koushiniku/bvclock/schematics/bvclock.pdf

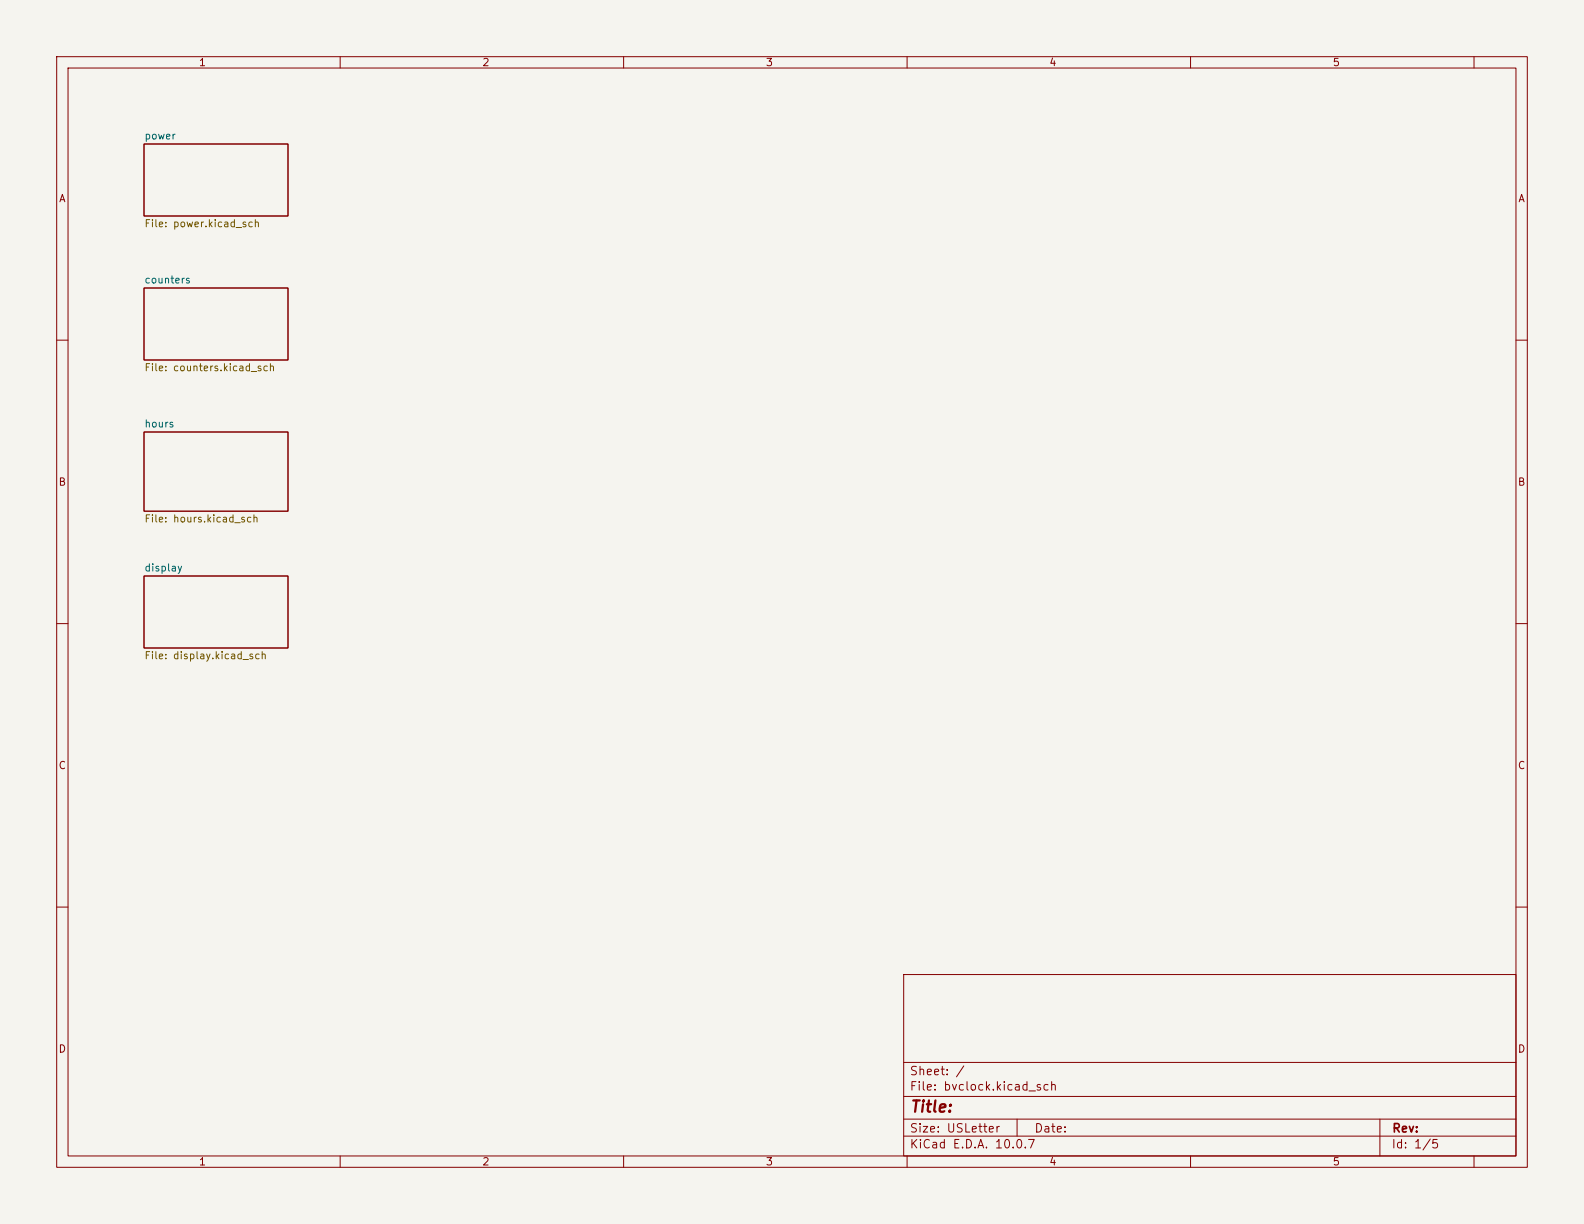
[picture p1: page 1]

Size: USLetter | Rev:
KiCad E.D.A. 10.0.7 | Id: 1/5

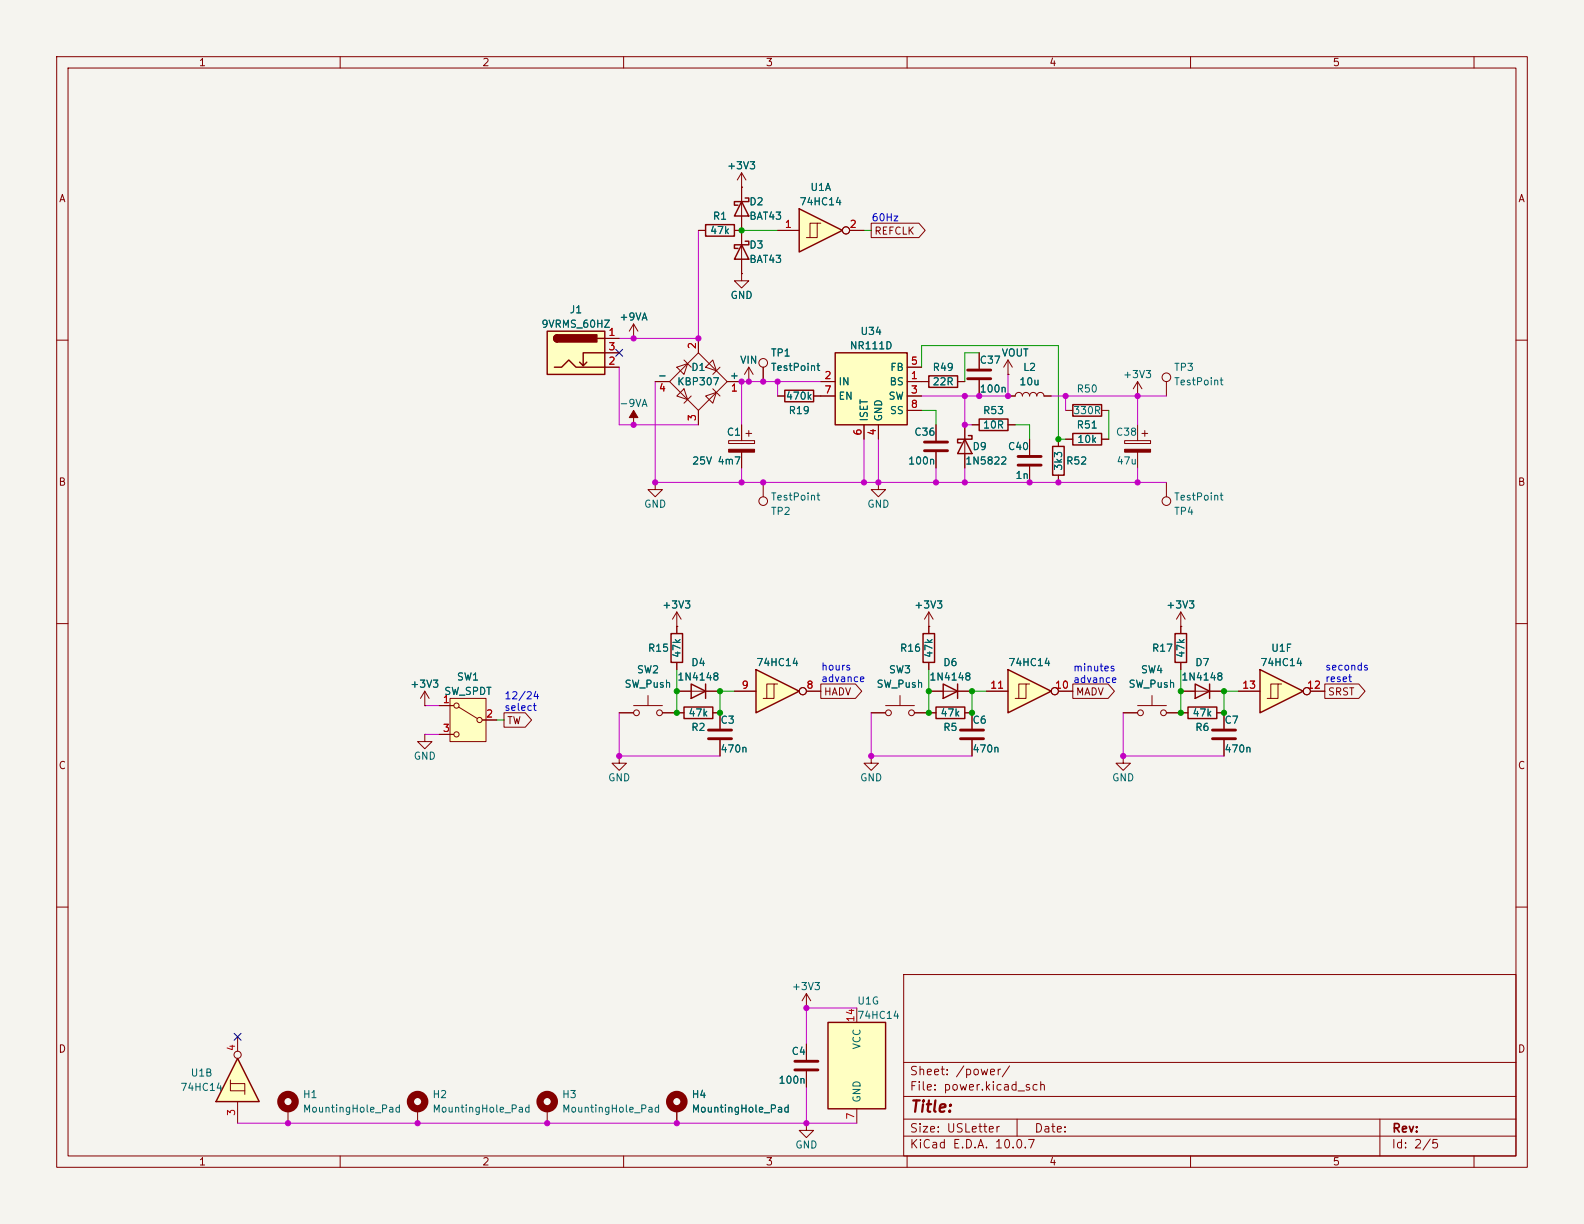
[picture p2: page 2]

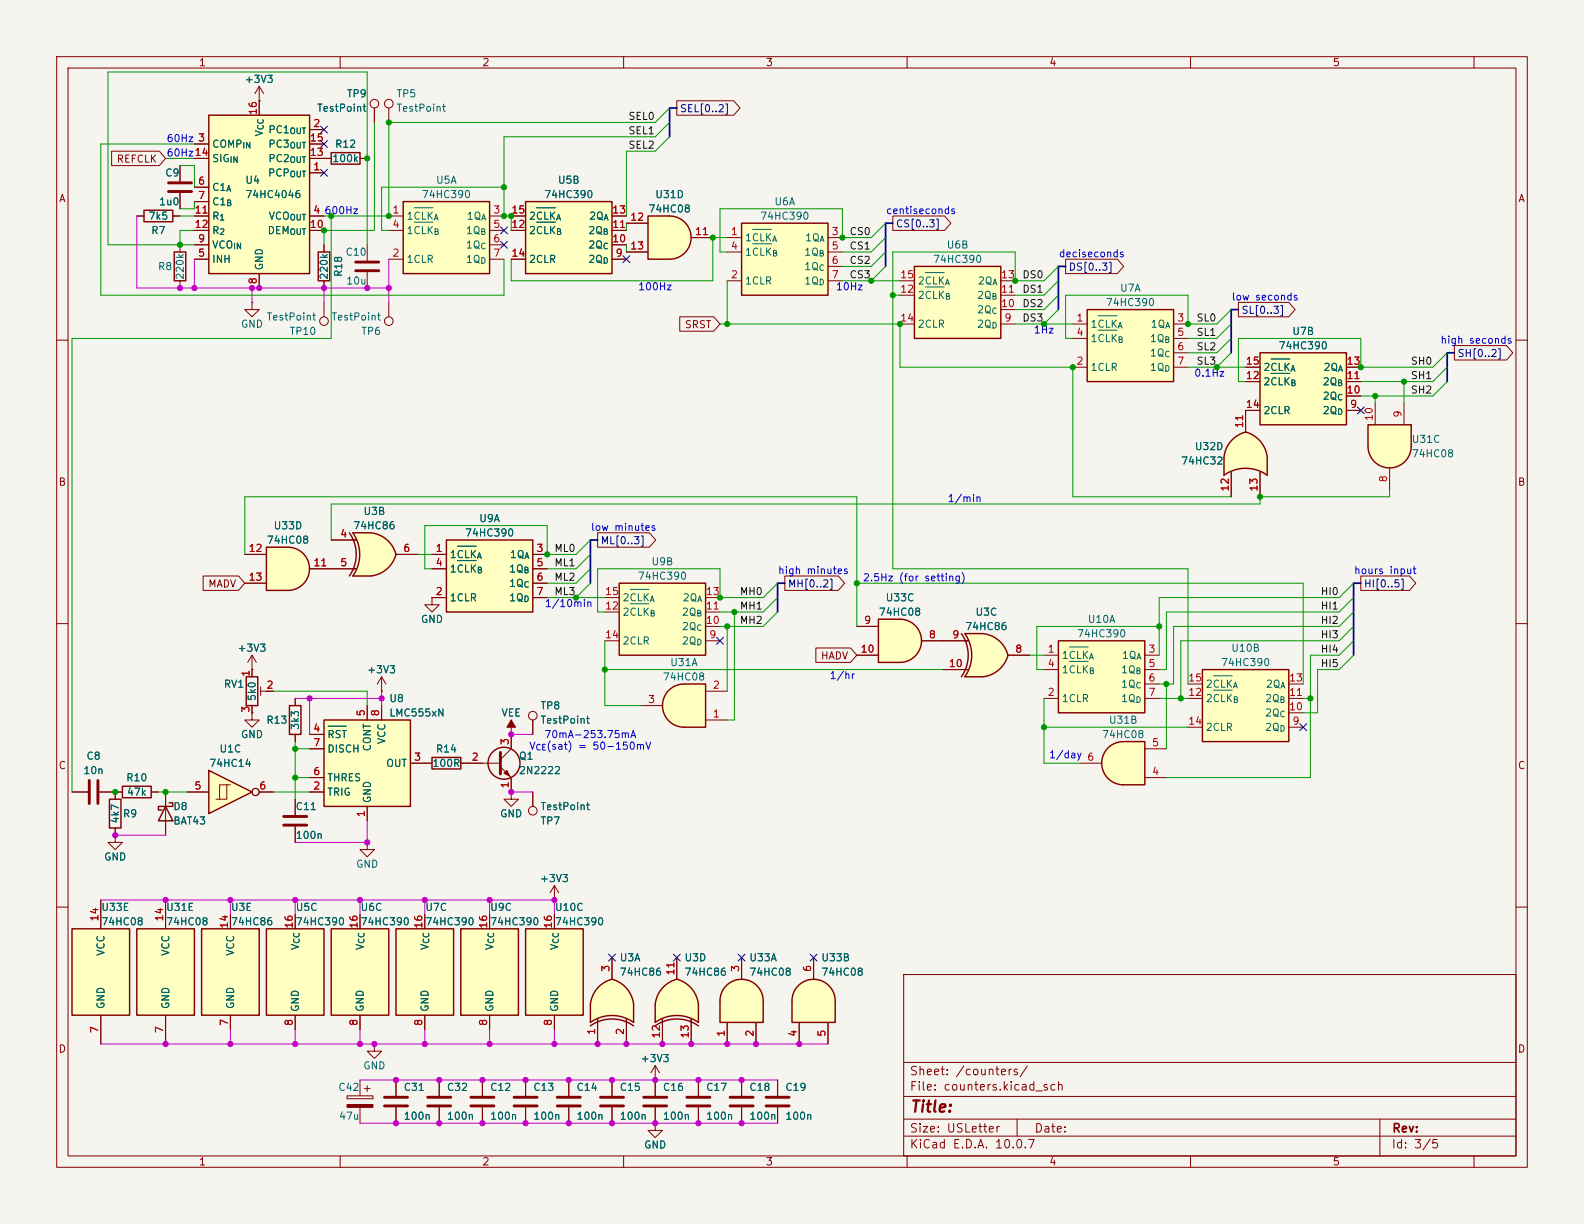
[picture p3: page 3]

74HC390 GND | 74HC390 GND | 74HC390 GND | 74HC390 GND | 74HC390 GND

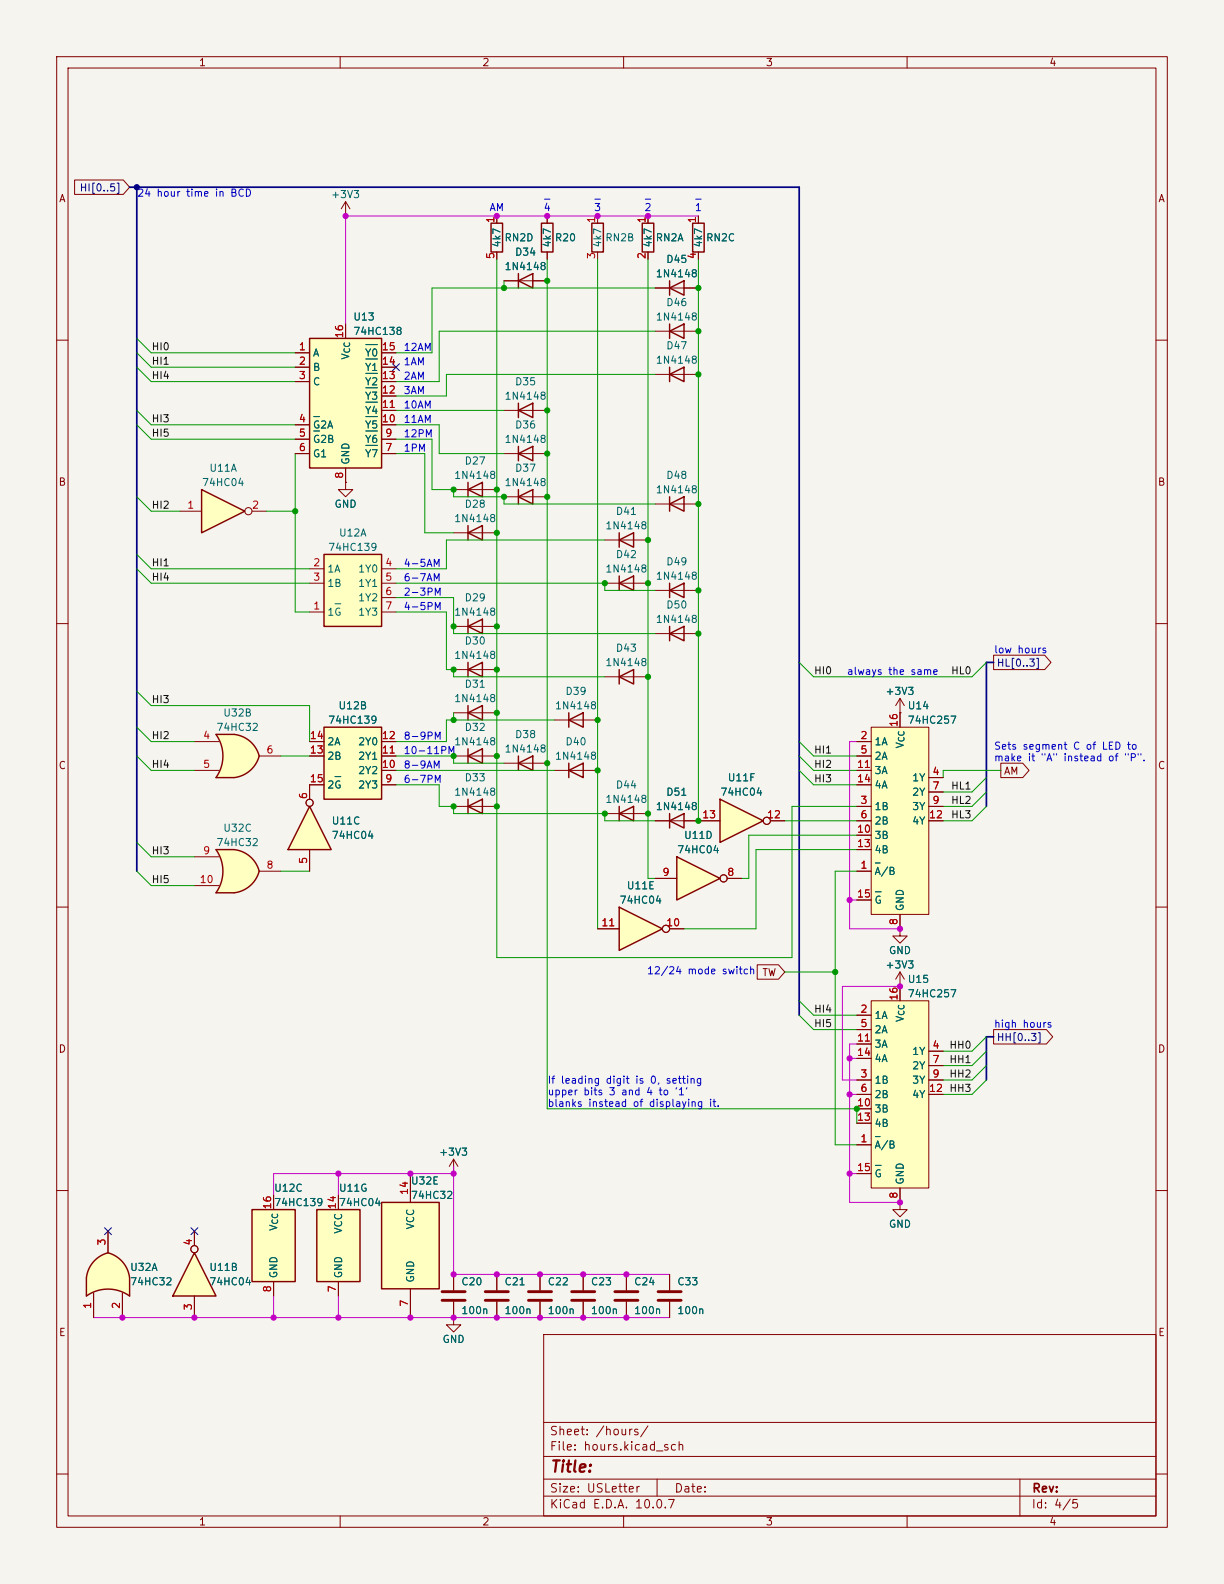
[picture p4: page 4]

24 hour time in BCD

8-9AM
6-7PM

If leading digit is 0, setting
upper bits 3 and 4 to '1' blanks instead of displaying it.

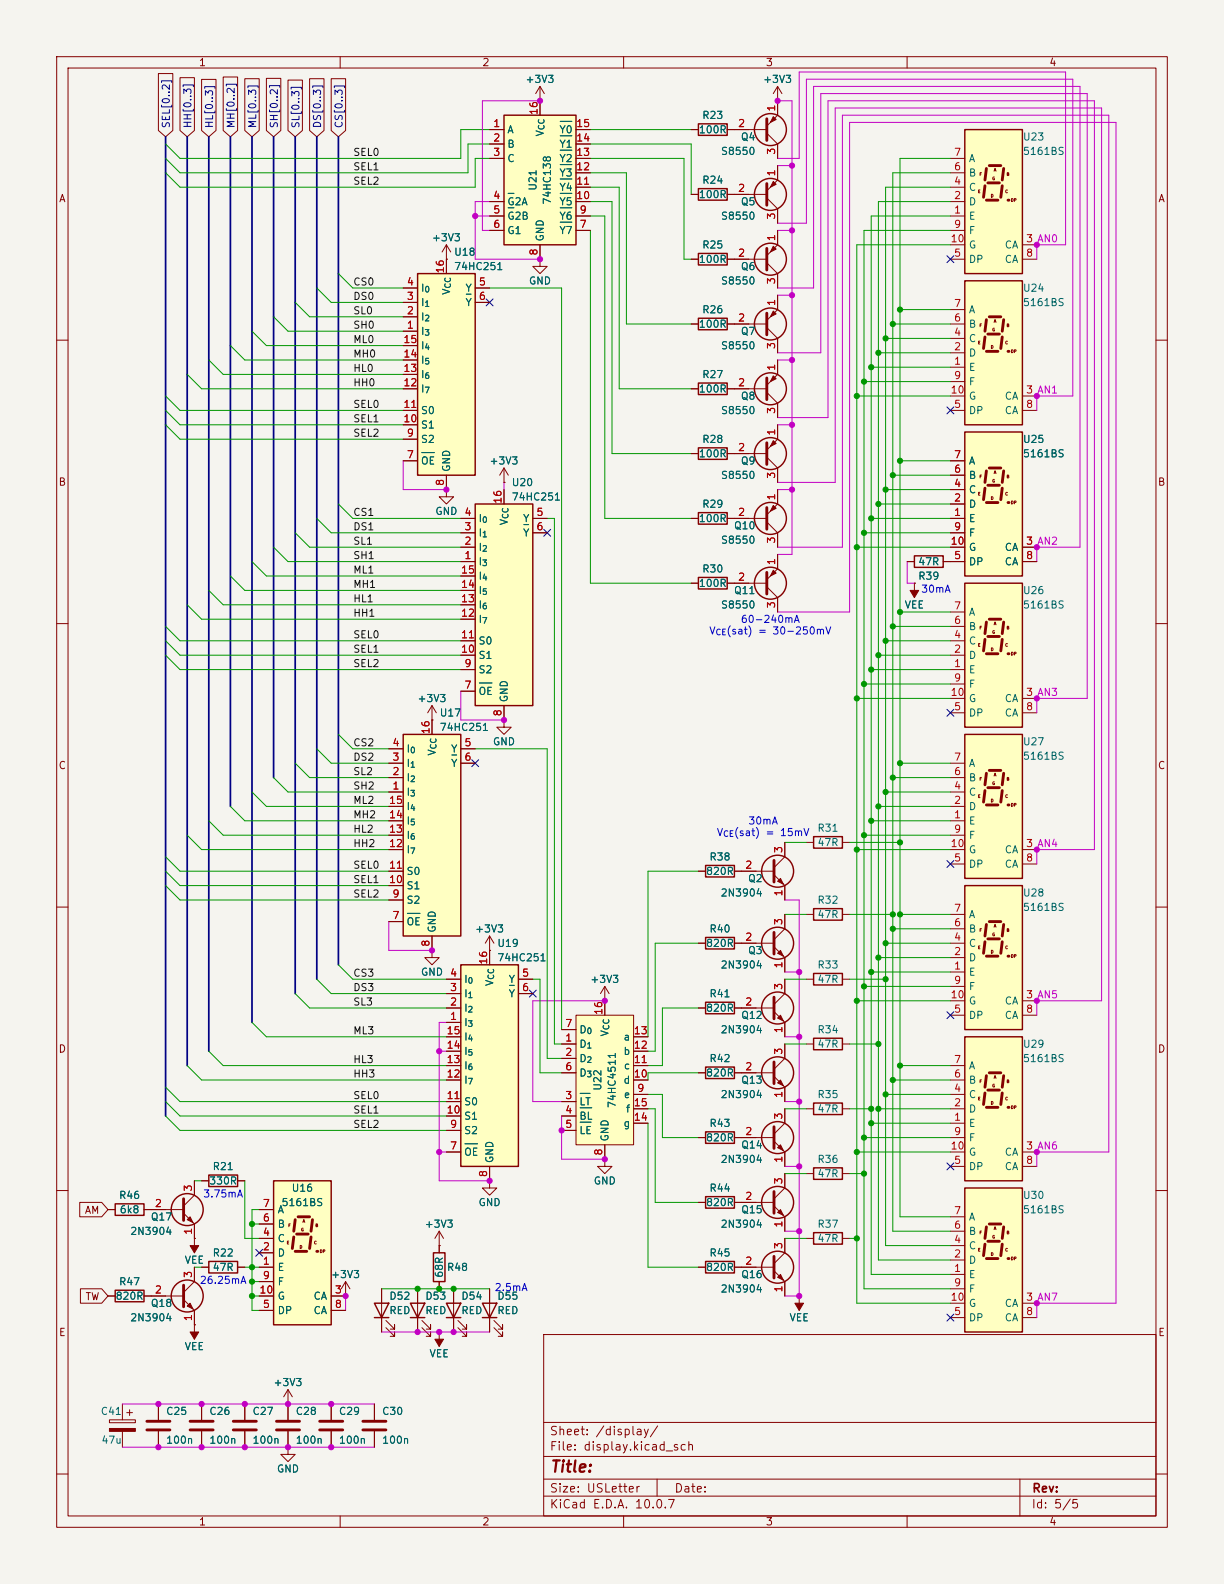
[picture p5: page 5]

SEL1
