koushiniku/bvclock/schematics/bvclock.kicad_pcb

## KiCad design schematics/bvclock.kicad_pcb (2026-10-28)

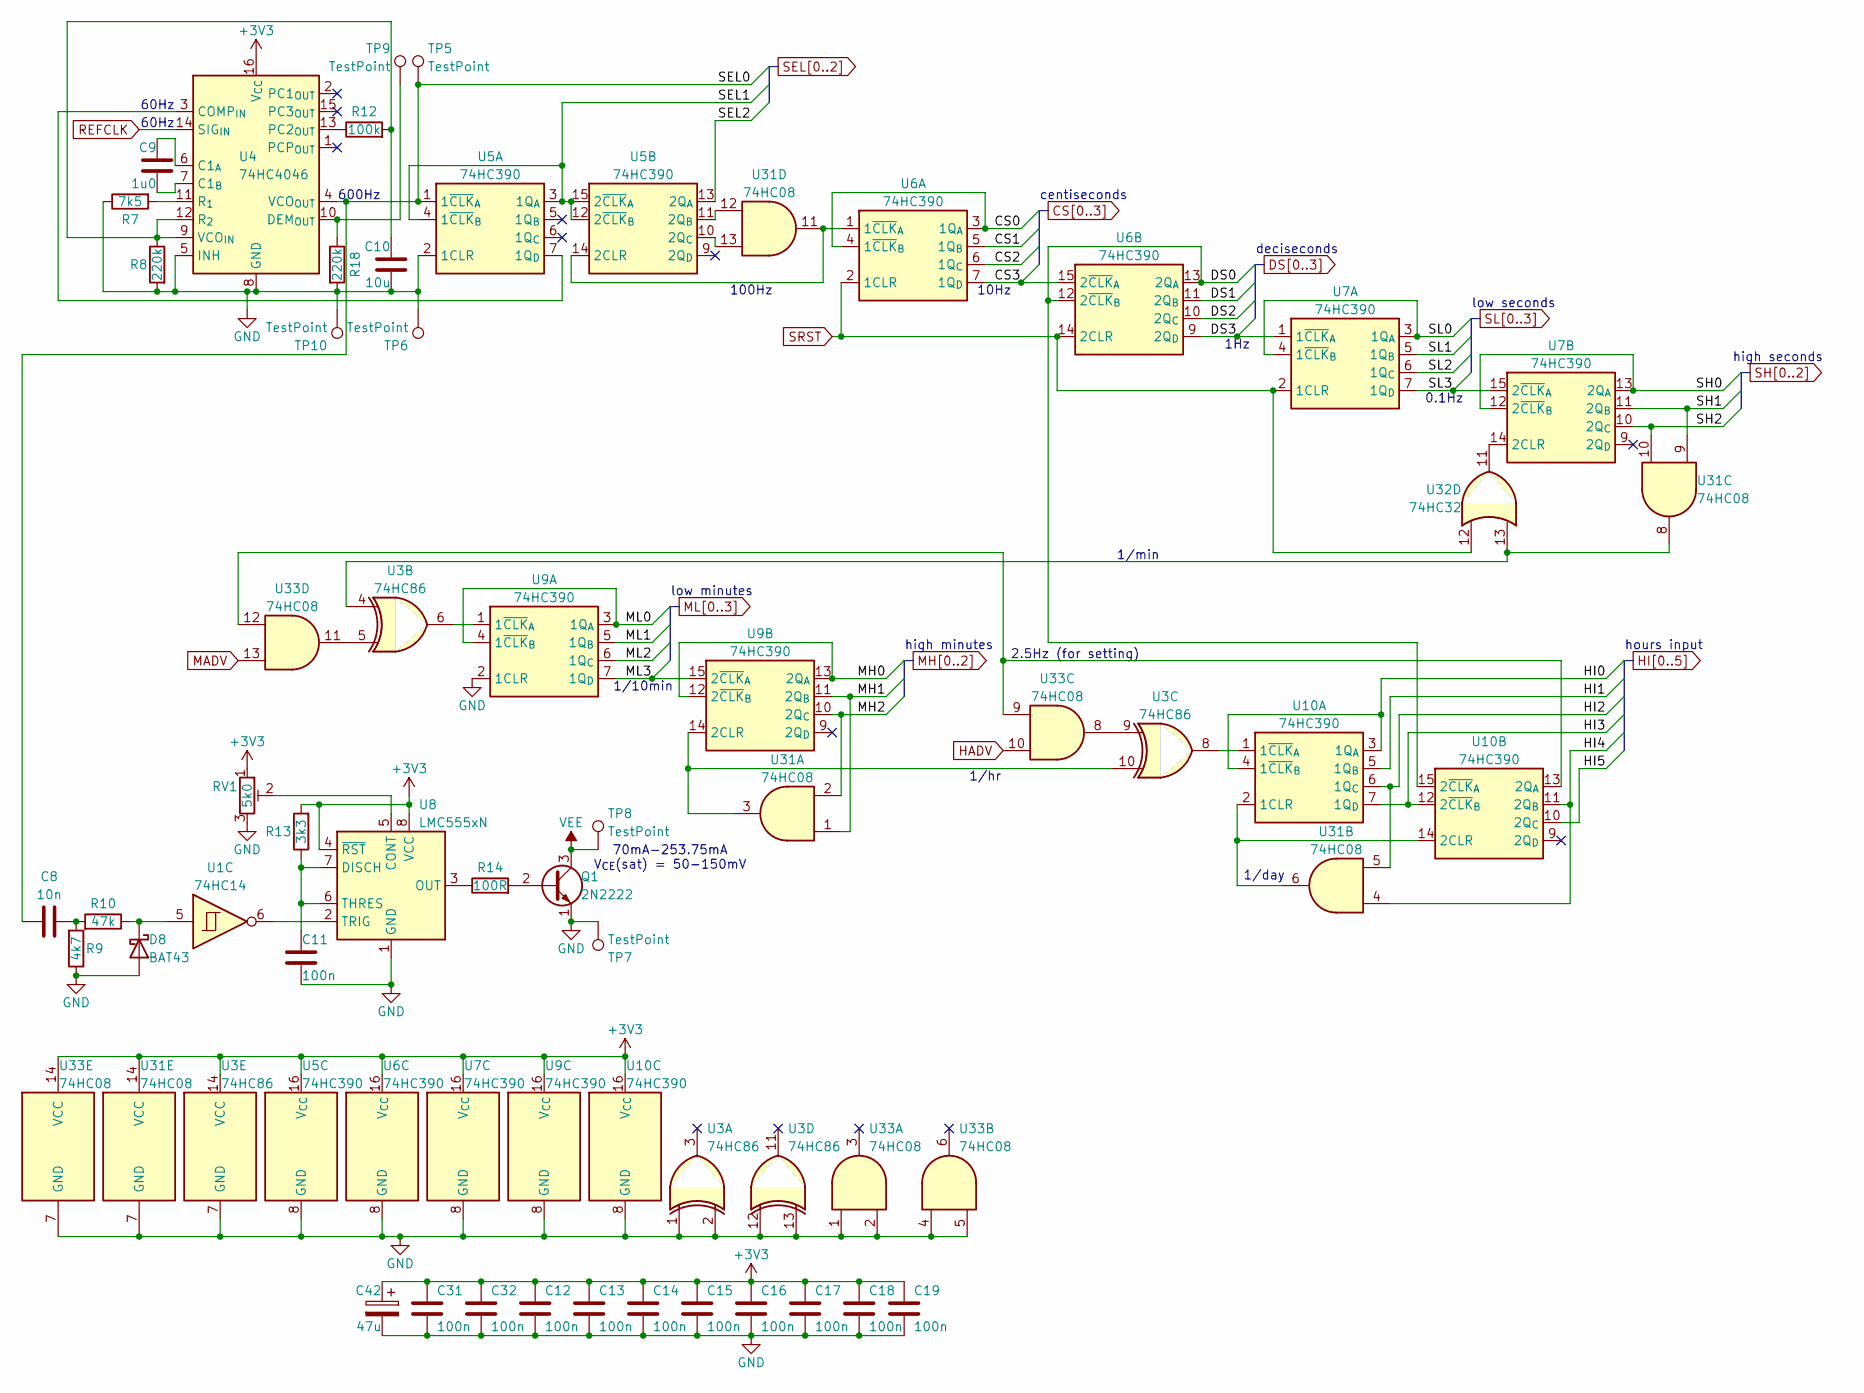
[picture p6: schematic counters.kicad_sch]

Parts:
C8: 10n; THT_Cap
C9: 1u0; THT_Cap
C10: 10u; THT_Cap
C11, C12, C13, C14, C15, C16, C17, C18, C19, C31, C32: 100n; THT_Cap
C42: 47u; CP_Radial_D5.0mm_P2.00mm
D8: BAT43; THT_D_Vertical
Q1: 2N2222; TO-92_HandSolder
R7: 7k5; THT_R_Vertical
R8, R18: 220k; THT_R_Vertical
R9: 4k7; THT_R_Vertical
R10: 47k; THT_R_Vertical
R12: 100k; THT_R_Vertical
R13: 3k3; THT_R_Vertical
R14: 100R; THT_R_Vertical
RV1: 5k0; Bourns_3362P_Trimming_Potentiometer
TP5, TP8, TP9: TestPoint; TestPoint_THTPad_2.5x2.5mm_Drill1.2mm
TP6, TP7, TP10: TestPoint; TestPoint_THTPad_D1.0mm_Drill0.5mm
U1: 74HC14; DIP-14_W7.62mm
U3: 74HC86; DIP-14_W7.62mm
U4: 74HC4046; DIP-16_W7.62mm
U5, U6, U7, U9, U10: 74HC390; DIP-16_W7.62mm
U8: LMC555xN; DIP-8_W7.62mm
U31, U33: 74HC08; DIP-14_W7.62mm
U32: 74HC32; DIP-14_W7.62mm

Connections:
+3V3: C12.1, C13.1, C14.1, C15.1, C16.1, C17.1, C18.1, C19.1, C31.1, C32.1, C42.1, R13.2, RV1.1, U3.14 (VCC), U4.16 (V_{CC}), U5.16 (V_{CC}), U6.16 (V_{CC}), U7.16 (V_{CC}), U8.4 (~RST), U8.8 (VCC), U9.16 (V_{CC}), U10.16 (V_{CC}), U31.14 (VCC), U33.14 (VCC); also elsewhere on the board
CS0: U6.3 (1Q_{A}), U6.4 (1~CLK_{B}); also elsewhere on the board
CS1: U6.5 (1Q_{B}); also elsewhere on the board
CS2: U6.6 (1Q_{C}); also elsewhere on the board
CS3: U6.7 (1Q_{D}), U6.15 (2~CLK_{A}); also elsewhere on the board
DS0: U6.12 (2~CLK_{B}), U6.13 (2Q_{A}), U10.15 (2~CLK_{A}); also elsewhere on the board
DS1: U6.11 (2Q_{B}); also elsewhere on the board
DS2: U6.10 (2Q_{C}); also elsewhere on the board
DS3: U6.9 (2Q_{D}), U7.1 (1~CLK_{A}); also elsewhere on the board
GND: C10.2, C11.2, C12.2, C13.2, C14.2, C15.2, C16.2, C17.2, C18.2, C19.2, C31.2, C32.2, C42.2, D8.2 (A), Q1.1 (E), R7.1, R8.2, R9.1, R18.2, RV1.3, TP6.1 (1_1), TP7.1 (1_1), TP10.1 (1_1), U3.1, U3.2, U3.7 (GND), U3.12, U3.13, U4.5 (INH), U4.8 (GND), U5.2 (1CLR), U5.8 (GND), U6.8 (GND), U7.8 (GND), U8.1 (GND), U9.2 (1CLR), U9.8 (GND), U10.8 (GND), U31.7 (GND), U33.1, U33.2, U33.4, U33.5, U33.7 (GND); also elsewhere on the board
HADV: U33.10; also elsewhere on the board
HI0: U10.3 (1Q_{A}), U10.4 (1~CLK_{B}); also elsewhere on the board
HI1: U10.5 (1Q_{B}); also elsewhere on the board
HI2: U10.6 (1Q_{C}), U31.5; also elsewhere on the board
HI3: U10.7 (1Q_{D}), U10.12 (2~CLK_{B}); also elsewhere on the board
HI4: U10.11 (2Q_{B}), U31.4; also elsewhere on the board
HI5: U10.10 (2Q_{C}); also elsewhere on the board
MADV: U33.13; also elsewhere on the board
MH0: U9.12 (2~CLK_{B}), U9.13 (2Q_{A}); also elsewhere on the board
MH1: U9.11 (2Q_{B}), U31.1; also elsewhere on the board
MH2: U9.10 (2Q_{C}), U31.2; also elsewhere on the board
ML0: U9.3 (1Q_{A}), U9.4 (1~CLK_{B}); also elsewhere on the board
ML1: U9.5 (1Q_{B}); also elsewhere on the board
ML2: U9.6 (1Q_{C}); also elsewhere on the board
ML3: U9.7 (1Q_{D}), U9.15 (2~CLK_{A}); also elsewhere on the board
unnamed: C8.2, R9.2, R10.2
unnamed: D8.1 (K), R10.1, U1.5
unnamed: Q1.2 (B), R14.2
unnamed: U3.4, U31.8, U32.13
unnamed: U3.5, U33.11
unnamed: U3.9, U33.8
unnamed: C9.1, U4.6 (C1_{A})
unnamed: C9.2, U4.7 (C1_{B})
unnamed: U4.3 (COMP_{IN}), U5.7 (1Q_{D})
unnamed: R18.1, TP9.1 (1_1), U4.10 (DEM_{OUT})
unnamed: R12.1, U4.13 (PC2_{OUT})
unnamed: R7.2, U4.11 (R_{1})
unnamed: C10.1, R8.1, R12.2, U4.9 (VCO_{IN}), U4.12 (R_{2})
unnamed: U5.14 (2CLR), U6.1 (1~CLK_{A}), U31.11
unnamed: U5.11 (2Q_{B}), U31.12
unnamed: U5.10 (2Q_{C}), U31.13
unnamed: U7.14 (2CLR), U32.11
unnamed: RV1.2, U8.5 (CONT)
unnamed: C11.1, R13.1, U8.6 (THRES), U8.7 (DISCH)
unnamed: R14.1, U8.3 (OUT)
unnamed: U1.6, U8.2 (TRIG)
unnamed: U3.6, U9.1 (1~CLK_{A})
unnamed: U3.10, U9.14 (2CLR), U31.3
unnamed: U10.2 (1CLR), U10.14 (2CLR), U31.6
unnamed: U3.8, U10.1 (1~CLK_{A})
unnamed: U10.13 (2Q_{A}), U33.9, U33.12
REFCLK: U4.14 (SIG_{IN}); also elsewhere on the board
SEL0: C8.1, TP5.1 (1_1), U4.4 (VCO_{OUT}), U5.1 (1~CLK_{A}); also elsewhere on the board
SEL1: U5.3 (1Q_{A}), U5.4 (1~CLK_{B}), U5.12 (2~CLK_{B}), U5.15 (2~CLK_{A}); also elsewhere on the board
SEL2: U5.13 (2Q_{A}); also elsewhere on the board
SH0: U7.12 (2~CLK_{B}), U7.13 (2Q_{A}); also elsewhere on the board
SH1: U7.11 (2Q_{B}), U31.9; also elsewhere on the board
SH2: U7.10 (2Q_{C}), U31.10; also elsewhere on the board
SL0: U7.3 (1Q_{A}), U7.4 (1~CLK_{B}); also elsewhere on the board
SL1: U7.5 (1Q_{B}); also elsewhere on the board
SL2: U7.6 (1Q_{C}); also elsewhere on the board
SL3: U7.7 (1Q_{D}), U7.15 (2~CLK_{A}); also elsewhere on the board
SRST: U6.2 (1CLR), U6.14 (2CLR), U7.2 (1CLR), U32.12; also elsewhere on the board
VEE: Q1.3 (C), TP8.1 (1_1); also elsewhere on the board

Notes on the sheet:
low minutes
1/day
hours input
60Hz
1/hr
0.1Hz
high seconds
2.5Hz (for setting)
high minutes
100Hz
70mA-253.75mA V_{CE}(sat) = 50-150mV
1/10min
low seconds
deciseconds
1Hz
600Hz
centiseconds
10Hz
1/min

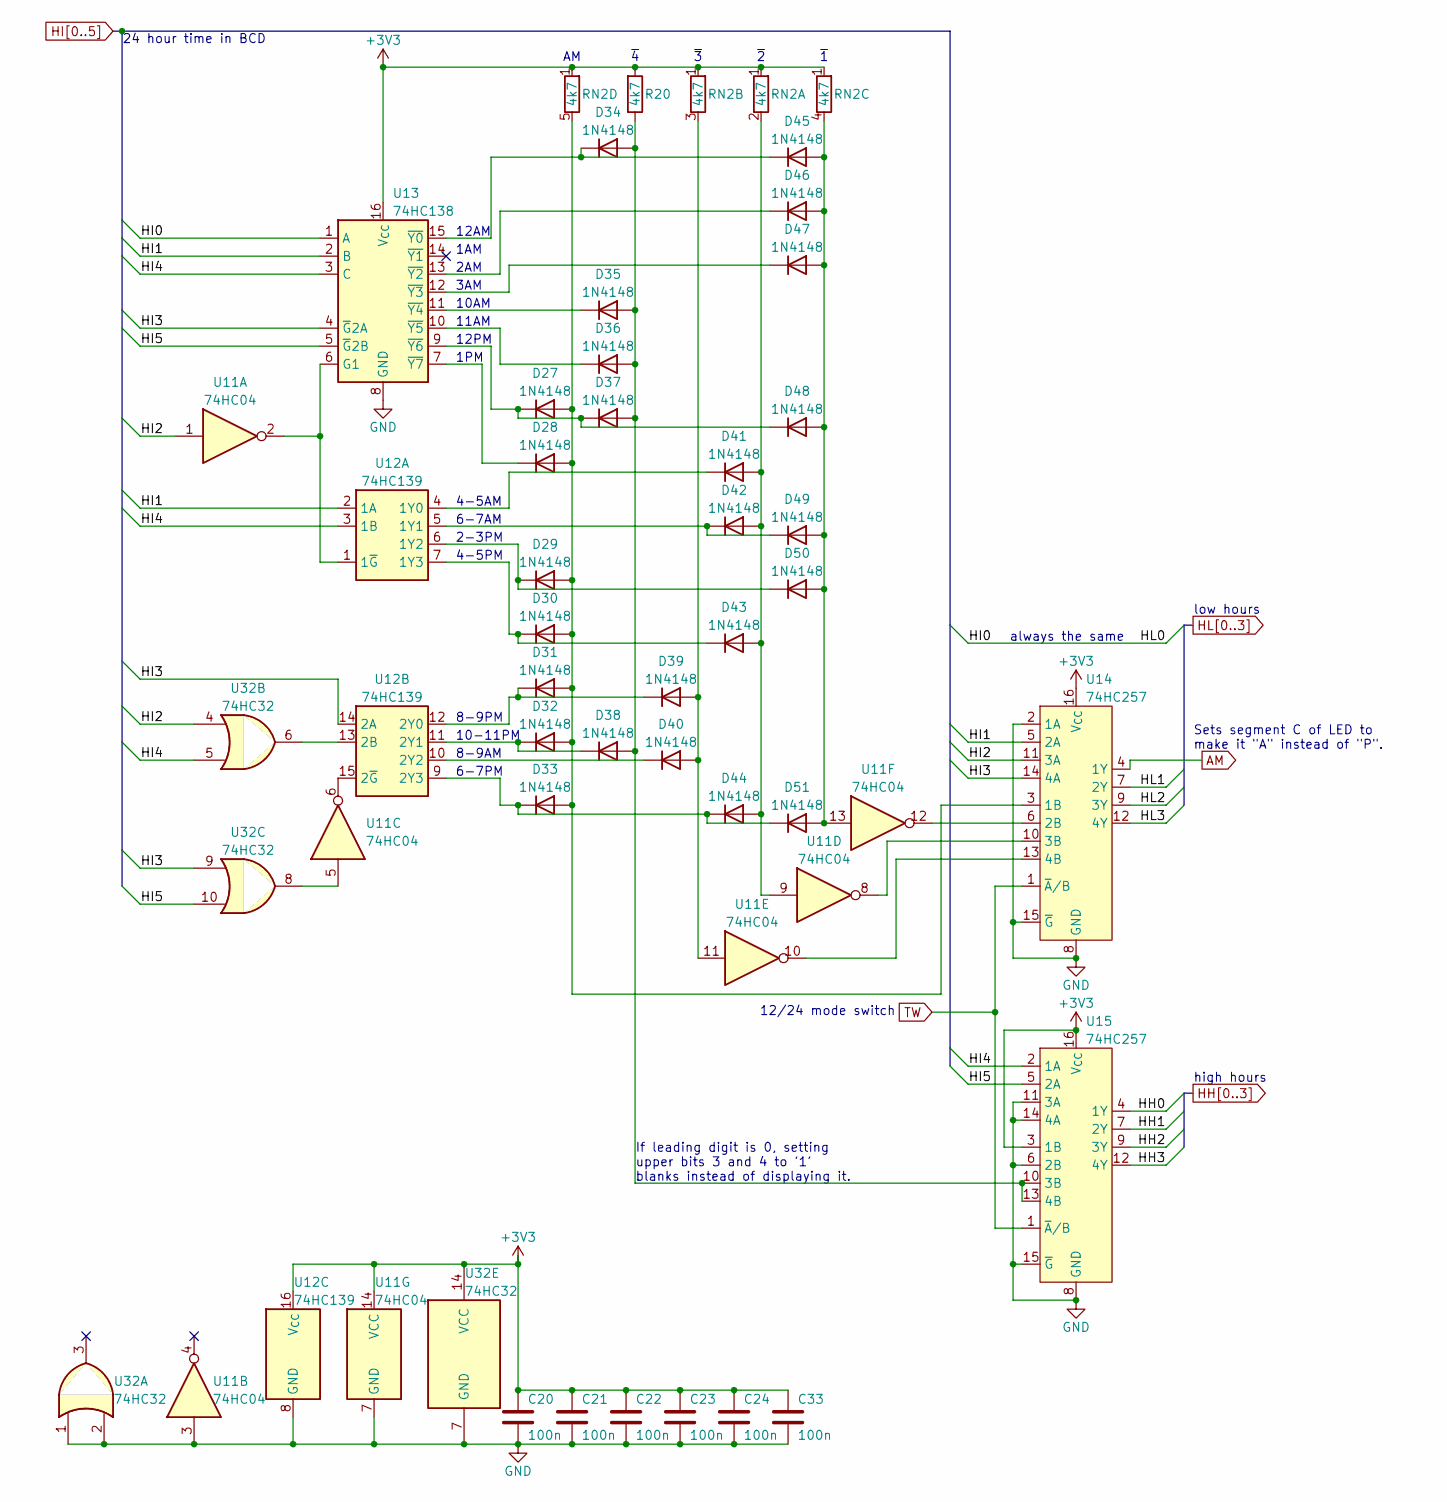
[picture p7: schematic hours.kicad_sch]

Parts:
C20, C21, C22, C23, C24, C33: 100n; THT_Cap
D27, D28, D29, D30, D31, D32, D33, D34, D35, D36, D37, D38, D39, D40, D41, D42, D43, D44, D45, D46, D47, D48, D49, D50, D51: 1N4148; THT_D_Vertical
R20: 4k7; THT_R_Vertical
RN2: 4k7; R_Array_SIP5
U11: 74HC04; DIP-14_W7.62mm
U12: 74HC139; DIP-16_W7.62mm
U13: 74HC138; DIP-16_W7.62mm
U14, U15: 74HC257; DIP-16_W7.62mm
U32: 74HC32; DIP-14_W7.62mm

Connections:
+3V3: C20.1, C21.1, C22.1, C23.1, C24.1, C33.1, R20.2, RN2.1 (R1), U11.14 (VCC), U12.16 (V_{CC}), U13.16 (V_{CC}), U14.16 (V_{CC}), U15.3 (1B), U15.16 (V_{CC}), U32.14 (VCC); also elsewhere on the board
AM: U14.4 (1Y); also elsewhere on the board
GND: C20.2, C21.2, C22.2, C23.2, C24.2, C33.2, U11.3, U11.7 (GND), U12.8 (GND), U13.8 (GND), U14.2 (1A), U14.8 (GND), U14.15 (~G), U15.6 (2B), U15.8 (GND), U15.11 (3A), U15.14 (4A), U15.15 (~G), U32.1, U32.2, U32.7 (GND); also elsewhere on the board
HH0: U15.4 (1Y); also elsewhere on the board
HH1: U15.7 (2Y); also elsewhere on the board
HH2: U15.9 (3Y); also elsewhere on the board
HH3: U15.12 (4Y); also elsewhere on the board
HI0: U13.1 (A); also elsewhere on the board
HI1: U12.2 (1A), U13.2 (B), U14.5 (2A); also elsewhere on the board
HI2: U11.1, U14.11 (3A), U32.4; also elsewhere on the board
HI3: U12.14 (2A), U13.4 (~G2A), U14.14 (4A), U32.9; also elsewhere on the board
HI4: U12.3 (1B), U13.3 (C), U15.2 (1A), U32.5; also elsewhere on the board
HI5: U13.5 (~G2B), U15.5 (2A), U32.10; also elsewhere on the board
HL1: U14.7 (2Y); also elsewhere on the board
HL2: U14.9 (3Y); also elsewhere on the board
HL3: U14.12 (4Y); also elsewhere on the board
unnamed: D27.2 (A), D28.2 (A), D29.2 (A), D30.2 (A), D31.2 (A), D32.2 (A), D33.2 (A), RN2.5 (R4.2), U14.3 (1B)
unnamed: D27.1 (K), D37.1 (K), D48.1 (K), U13.9 (~Y6)
unnamed: D28.1 (K), U13.7 (~Y7)
unnamed: D29.1 (K), D50.1 (K), U12.6 (1Y2)
unnamed: D30.1 (K), D43.1 (K), U12.7 (1Y3)
unnamed: D31.1 (K), D39.1 (K), U12.12 (2Y0)
unnamed: D32.1 (K), D38.1 (K), U12.11 (2Y1)
unnamed: D33.1 (K), D44.1 (K), D51.1 (K), U12.9 (2Y3)
unnamed: D34.2 (A), D35.2 (A), D36.2 (A), D37.2 (A), D38.2 (A), R20.1, U15.10 (3B), U15.13 (4B)
unnamed: D34.1 (K), D45.1 (K), U13.15 (~Y0)
unnamed: D35.1 (K), U13.11 (~Y4)
unnamed: D36.1 (K), U13.10 (~Y5)
unnamed: D39.2 (A), D40.2 (A), RN2.3 (R2.2), U11.11
unnamed: D40.1 (K), U12.10 (2Y2)
unnamed: D41.2 (A), D42.2 (A), D43.2 (A), D44.2 (A), RN2.2 (R1.2), U11.9
unnamed: D41.1 (K), U12.4 (1Y0)
unnamed: D42.1 (K), D49.1 (K), U12.5 (1Y1)
unnamed: D45.2 (A), D46.2 (A), D47.2 (A), D48.2 (A), D49.2 (A), D50.2 (A), D51.2 (A), RN2.4 (R3.2), U11.13
unnamed: D46.1 (K), U13.13 (~Y2)
unnamed: D47.1 (K), U13.12 (~Y3)
unnamed: U11.5, U32.8
unnamed: U11.2, U12.1 (1~G), U13.6 (G1)
unnamed: U12.13 (2B), U32.6
unnamed: U11.6, U12.15 (2~G)
unnamed: U11.12, U14.6 (2B)
unnamed: U11.8, U14.10 (3B)
unnamed: U11.10, U14.13 (4B)
TW: U14.1 (~A/B), U15.1 (~A/B); also elsewhere on the board

Notes on the sheet:
If leading digit is 0, setting upper bits 3 and 4 to '1' blanks instead of displaying it.
4-5AM
2AM
24 hour time in BCD
~{3}
~{2}
12AM
1AM
12/24 mode switch
low hours
11AM
6-7PM
6-7AM
2-3PM
1PM
12PM
Sets segment C of LED to make it "A" instead of "P".
3AM
10AM
high hours
~{4}
~{1}
8-9PM
always the same
8-9AM
4-5PM
10-11PM

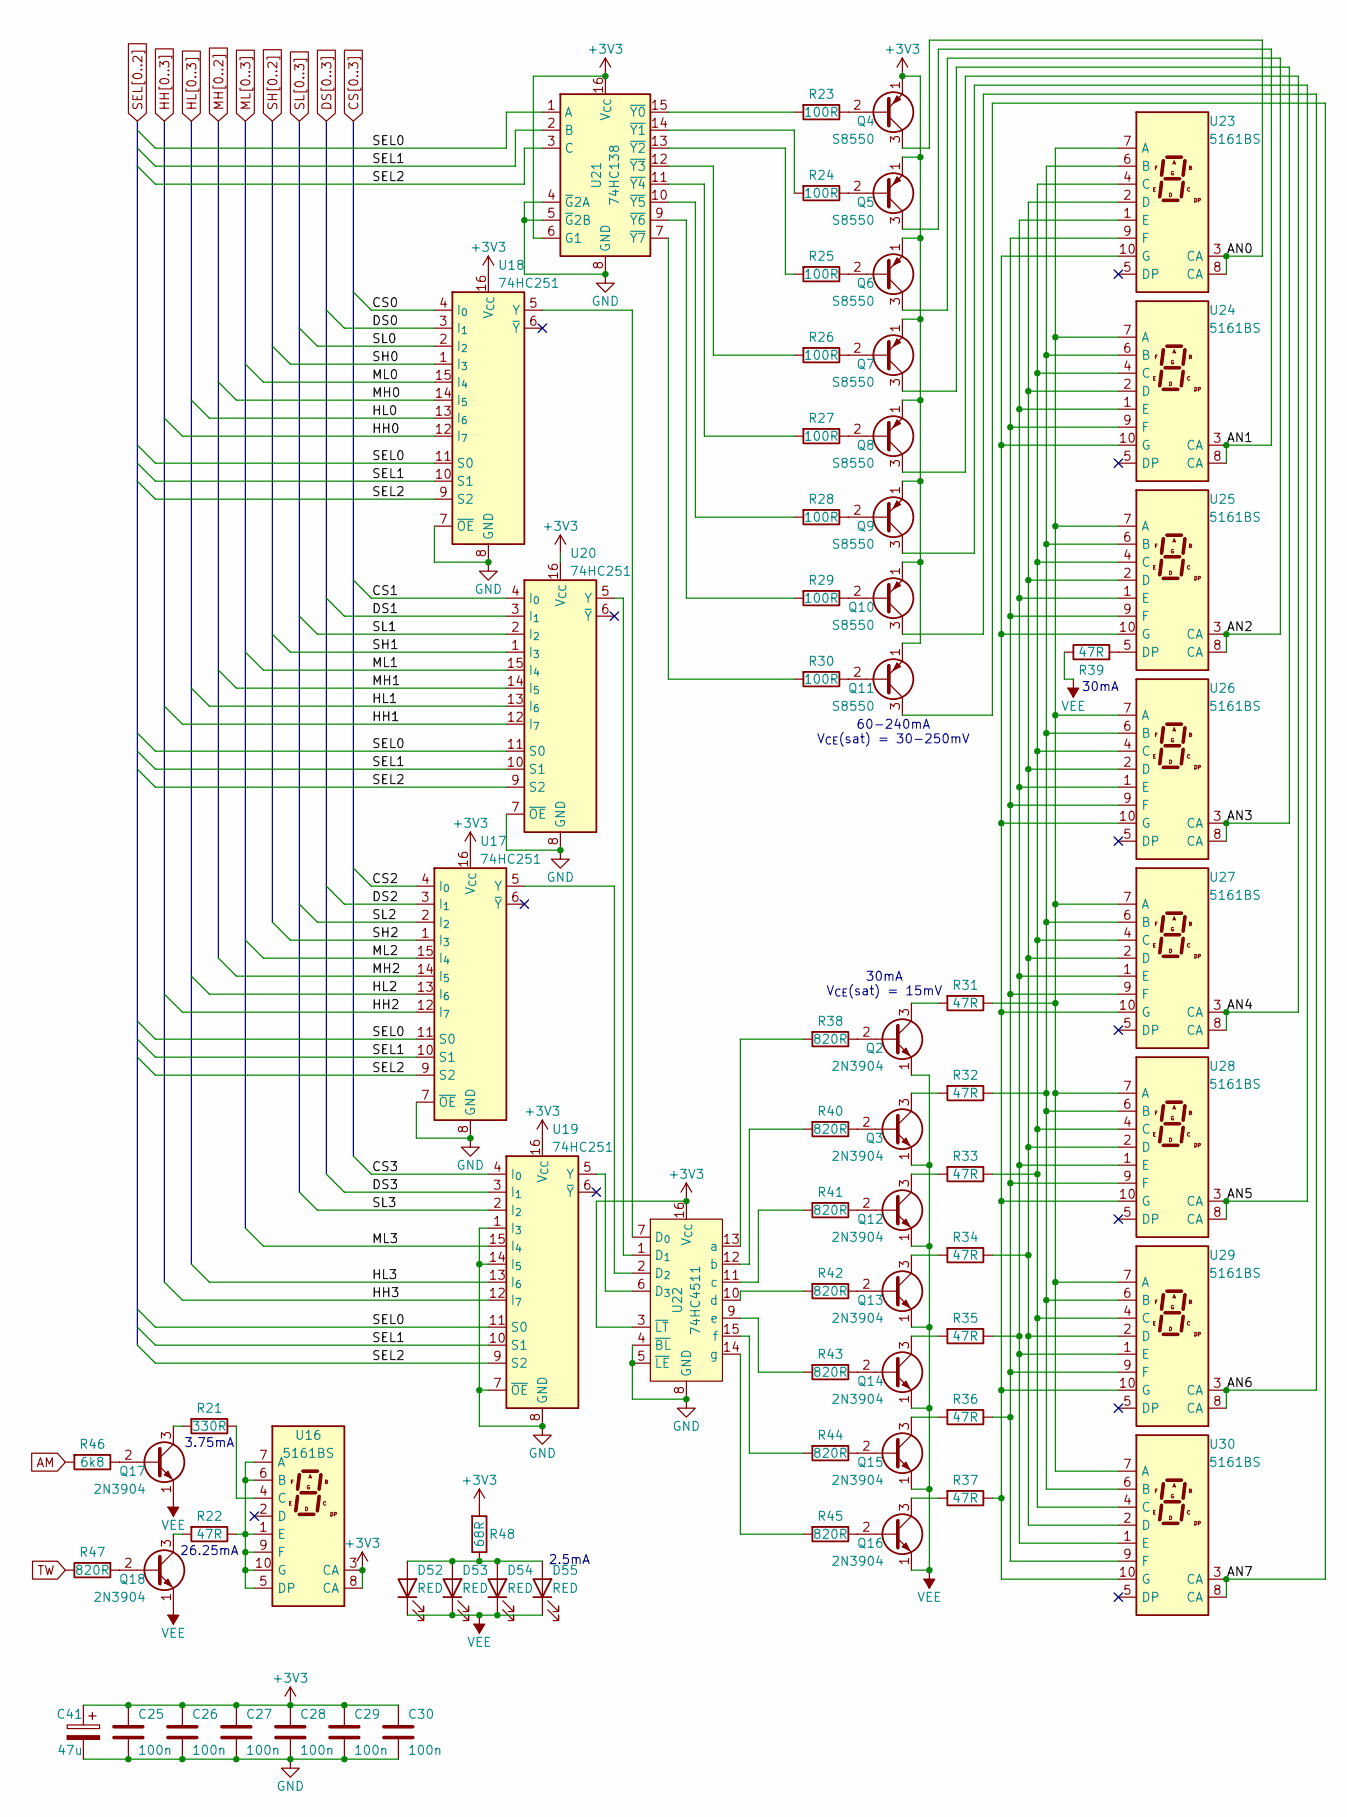
[picture p8: schematic display.kicad_sch]

Parts:
C25, C26, C27, C28, C29, C30: 100n; THT_Cap
C41: 47u; CP_Radial_D5.0mm_P2.00mm
D52, D53, D54, D55: RED; LED_D5.0mm
Q2, Q3, Q12, Q13, Q14, Q15, Q16, Q17, Q18: 2N3904; TO-92_HandSolder
Q4, Q5, Q6, Q7, Q8, Q9, Q10, Q11: S8550; TO-92_HandSolder
R21: 330R; THT_R_Vertical
R22, R31, R32, R33, R34, R35, R36, R37, R39: 47R; THT_R_Vertical
R23, R24, R25, R26, R27, R28, R29, R30: 100R; THT_R_Vertical
R38, R40, R41, R42, R43, R44, R45, R47: 820R; THT_R_Vertical
R46: 6k8; THT_R_Vertical
R48: 68R; THT_R_Vertical
U16, U23, U24, U25, U26, U27, U28, U29, U30: 5161BS; 7SegmentLED_LTS6760_LTS6780
U17, U18, U19, U20: 74HC251; DIP-16_W7.62mm
U21: 74HC138; DIP-16_W7.62mm
U22: 74HC4511; DIP-16_W7.62mm

Connections:
+3V3: C25.1, C26.1, C27.1, C28.1, C29.1, C30.1, C41.1, Q4.1 (E), Q5.1 (E), Q6.1 (E), Q7.1 (E), Q8.1 (E), Q9.1 (E), Q10.1 (E), Q11.1 (E), R48.2, U16.3 (CA), U16.8 (CA), U17.16 (V_{CC}), U18.16 (V_{CC}), U19.16 (V_{CC}), U20.16 (V_{CC}), U21.6 (G1), U21.16 (V_{CC}), U22.3 (~LT), U22.16 (V_{CC}); also elsewhere on the board
/display/AN0: Q4.3 (C), U23.3 (CA), U23.8 (CA)
/display/AN1: Q5.3 (C), U24.3 (CA), U24.8 (CA)
/display/AN2: Q6.3 (C), U25.3 (CA), U25.8 (CA)
/display/AN3: Q7.3 (C), U26.3 (CA), U26.8 (CA)
/display/AN4: Q8.3 (C), U27.3 (CA), U27.8 (CA)
/display/AN5: Q9.3 (C), U28.3 (CA), U28.8 (CA)
/display/AN6: Q10.3 (C), U29.3 (CA), U29.8 (CA)
/display/AN7: Q11.3 (C), U30.3 (CA), U30.8 (CA)
AM: R46.2; also elsewhere on the board
CS0: U18.4 (I_{0}); also elsewhere on the board
CS1: U20.4 (I_{0}); also elsewhere on the board
CS2: U17.4 (I_{0}); also elsewhere on the board
CS3: U19.4 (I_{0}); also elsewhere on the board
DS0: U18.3 (I_{1}); also elsewhere on the board
DS1: U20.3 (I_{1}); also elsewhere on the board
DS2: U17.3 (I_{1}); also elsewhere on the board
DS3: U19.3 (I_{1}); also elsewhere on the board
GND: C25.2, C26.2, C27.2, C28.2, C29.2, C30.2, C41.2, U17.7 (~OE), U17.8 (GND), U18.7 (~OE), U18.8 (GND), U19.1 (I_{3}), U19.7 (~OE), U19.8 (GND), U19.14 (I_{5}), U20.7 (~OE), U20.8 (GND), U21.4 (~G2A), U21.5 (~G2B), U21.8 (GND), U22.4 (~BL), U22.5 (~LE), U22.8 (GND); also elsewhere on the board
HH0: U18.12 (I_{7}); also elsewhere on the board
HH1: U20.12 (I_{7}); also elsewhere on the board
HH2: U17.12 (I_{7}); also elsewhere on the board
HH3: U19.12 (I_{7}); also elsewhere on the board
HI0: U18.13 (I_{6}); also elsewhere on the board
HL1: U20.13 (I_{6}); also elsewhere on the board
HL2: U17.13 (I_{6}); also elsewhere on the board
HL3: U19.13 (I_{6}); also elsewhere on the board
MH0: U18.14 (I_{5}); also elsewhere on the board
MH1: U20.14 (I_{5}); also elsewhere on the board
MH2: U17.14 (I_{5}); also elsewhere on the board
ML0: U18.15 (I_{4}); also elsewhere on the board
ML1: U20.15 (I_{4}); also elsewhere on the board
ML2: U17.15 (I_{4}); also elsewhere on the board
ML3: U19.15 (I_{4}); also elsewhere on the board
unnamed: D52.2 (A), D53.2 (A), D54.2 (A), D55.2 (A), R48.1
unnamed: Q2.2 (B), R38.1
unnamed: Q2.3 (C), R31.2
unnamed: Q3.2 (B), R40.1
unnamed: Q3.3 (C), R32.2
unnamed: Q4.2 (B), R23.1
unnamed: Q5.2 (B), R24.1
unnamed: Q6.2 (B), R25.1
unnamed: Q7.2 (B), R26.1
unnamed: Q8.2 (B), R27.1
unnamed: Q9.2 (B), R28.1
unnamed: Q10.2 (B), R29.1
unnamed: Q11.2 (B), R30.1
unnamed: Q12.2 (B), R41.1
unnamed: Q12.3 (C), R33.2
unnamed: Q13.2 (B), R42.1
unnamed: Q13.3 (C), R34.2
unnamed: Q14.2 (B), R43.1
unnamed: Q14.3 (C), R35.2
unnamed: Q15.2 (B), R44.1
unnamed: Q15.3 (C), R36.2
unnamed: Q16.2 (B), R45.1
unnamed: Q16.3 (C), R37.2
unnamed: Q17.2 (B), R46.1
unnamed: Q17.3 (C), R21.2
unnamed: Q18.2 (B), R47.2
unnamed: Q18.3 (C), R22.2
unnamed: R22.1, U16.1 (E), U16.5 (DP), U16.6 (B), U16.7 (A), U16.9 (F), U16.10 (G)
unnamed: R21.1, U16.4 (C)
unnamed: U17.5 (Y), U22.2 (D_{2})
unnamed: U18.5 (Y), U22.7 (D_{0})
unnamed: U19.5 (Y), U22.6 (D_{3})
unnamed: U20.5 (Y), U22.1 (D_{1})
unnamed: R23.2, U21.15 (~Y0)
unnamed: R24.2, U21.14 (~Y1)
unnamed: R25.2, U21.13 (~Y2)
unnamed: R26.2, U21.12 (~Y3)
unnamed: R27.2, U21.11 (~Y4)
unnamed: R28.2, U21.10 (~Y5)
unnamed: R29.2, U21.9 (~Y6)
unnamed: R30.2, U21.7 (~Y7)
unnamed: R38.2, U22.13 (a)
unnamed: R40.2, U22.12 (b)
unnamed: R41.2, U22.11 (c)
unnamed: R42.2, U22.10 (d)
unnamed: R43.2, U22.9 (e)
unnamed: R44.2, U22.15 (f)
unnamed: R45.2, U22.14 (g)
unnamed: R31.1, U23.7 (A), U24.7 (A), U25.7 (A), U26.7 (A), U27.7 (A), U28.7 (A), U29.7 (A), U30.7 (A)
unnamed: R32.1, U23.6 (B), U24.6 (B), U25.6 (B), U26.6 (B), U27.6 (B), U28.6 (B), U29.6 (B), U30.6 (B)
unnamed: R33.1, U23.4 (C), U24.4 (C), U25.4 (C), U26.4 (C), U27.4 (C), U28.4 (C), U29.4 (C), U30.4 (C)
unnamed: R34.1, U23.2 (D), U24.2 (D), U25.2 (D), U26.2 (D), U27.2 (D), U28.2 (D), U29.2 (D), U30.2 (D)
unnamed: R35.1, U23.1 (E), U24.1 (E), U25.1 (E), U26.1 (E), U27.1 (E), U28.1 (E), U29.1 (E), U30.1 (E)
unnamed: R36.1, U23.9 (F), U24.9 (F), U25.9 (F), U26.9 (F), U27.9 (F), U28.9 (F), U29.9 (F), U30.9 (F)
unnamed: R37.1, U23.10 (G), U24.10 (G), U25.10 (G), U26.10 (G), U27.10 (G), U28.10 (G), U29.10 (G), U30.10 (G)
unnamed: R39.2, U25.5 (DP)
SEL0: U17.11 (S0), U18.11 (S0), U19.11 (S0), U20.11 (S0), U21.1 (A); also elsewhere on the board
SEL1: U17.10 (S1), U18.10 (S1), U19.10 (S1), U20.10 (S1), U21.2 (B); also elsewhere on the board
SEL2: U17.9 (S2), U18.9 (S2), U19.9 (S2), U20.9 (S2), U21.3 (C); also elsewhere on the board
SH0: U18.1 (I_{3}); also elsewhere on the board
SH1: U20.1 (I_{3}); also elsewhere on the board
SH2: U17.1 (I_{3}); also elsewhere on the board
SL0: U18.2 (I_{2}); also elsewhere on the board
SL1: U20.2 (I_{2}); also elsewhere on the board
SL2: U17.2 (I_{2}); also elsewhere on the board
SL3: U19.2 (I_{2}); also elsewhere on the board
TW: R47.1; also elsewhere on the board
VEE: D52.1 (K), D53.1 (K), D54.1 (K), D55.1 (K), Q2.1 (E), Q3.1 (E), Q12.1 (E), Q13.1 (E), Q14.1 (E), Q15.1 (E), Q16.1 (E), Q17.1 (E), Q18.1 (E), R39.1; also elsewhere on the board

Notes on the sheet:
60-240mA V_{CE}(sat) = 30-250mV
30mA
26.25mA
30mA V_{CE}(sat) = 15mV
3.75mA
2.5mA

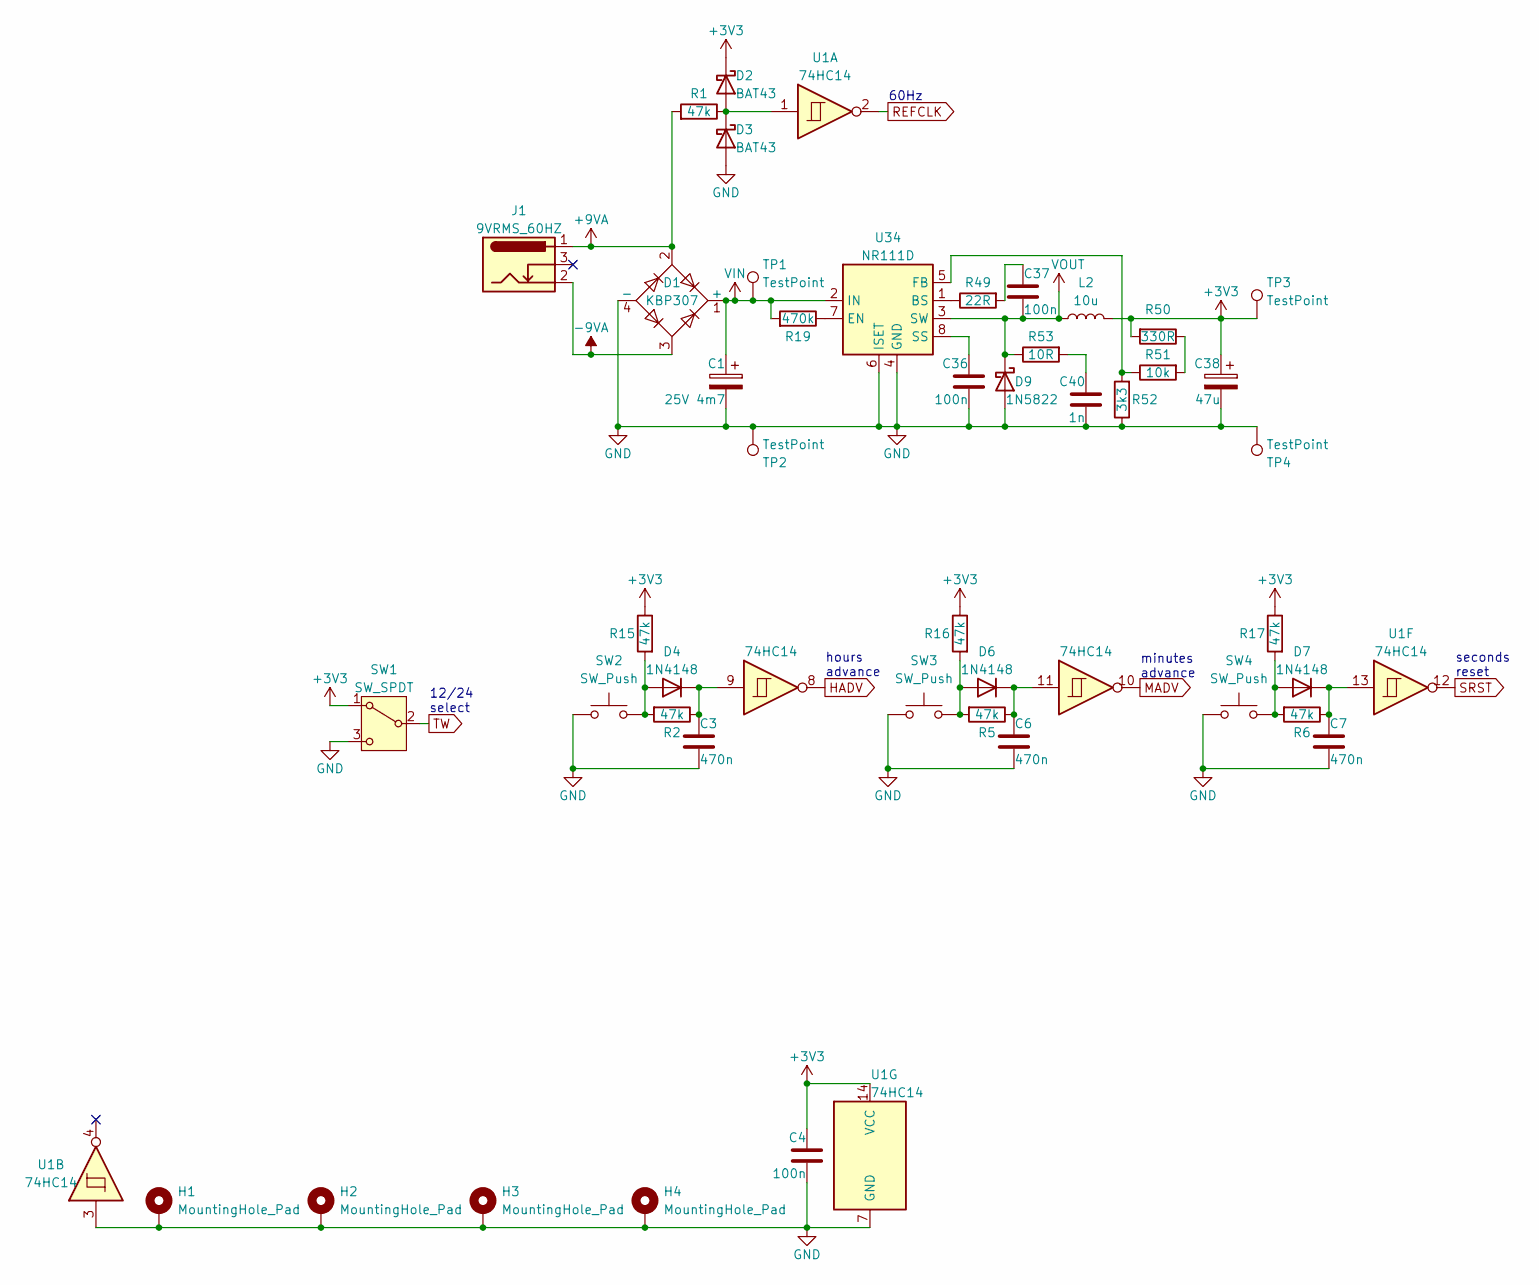
[picture p9: schematic power.kicad_sch]

Parts:
C1: 25V 4m7; CP_Radial_D16.0mm_P7.50mm
C3, C6, C7: 470n; THT_Cap
C4, C36, C37: 100n; THT_Cap
C38: 47u; CP_Radial_D5.0mm_P2.00mm
C40: 1n; THT_Cap
D1: KBP307; Diode_Bridge_Vishay_KBPM
D2, D3: BAT43; THT_D_Vertical
D4, D6, D7: 1N4148; THT_D_Vertical
D9: 1N5822; D_DO-201AD_P15.24mm_Horizontal
H1, H2, H3, H4: MountingHole_Pad; MountingHole_2.2mm_M2_ISO7380_Pad_TopBottom
J1: 9VRMS_60HZ; BarrelJack_Horizontal
L2: 10u; L_Toroid_Vertical_L14.9mm_W8.0mm_P7.40mm
R1, R2, R5, R6, R15, R16, R17: 47k; THT_R_Vertical
R19: 470k; THT_R_Vertical
R49: 22R; THT_R_Vertical
R50: 330R; THT_R_Vertical
R51: 10k; THT_R_Vertical
R52: 3k3; THT_R_Vertical
R53: 10R; THT_R_Vertical
SW1: SW_SPDT; SW_Slide_SPDT
SW2, SW3, SW4: SW_Push
TP1, TP3: TestPoint; TestPoint_THTPad_2.5x2.5mm_Drill1.2mm
TP2, TP4: TestPoint; TestPoint_THTPad_D1.0mm_Drill0.5mm
U1: 74HC14; DIP-14_W7.62mm
U34: NR111D; DIP-8_W7.62mm

Connections:
+3V3: C4.1, C38.1, D2.1 (K), L2.2, R15.1, R16.1, R17.1, R50.2, SW1.1 (A), TP3.1 (1_1), U1.14 (VCC); also elsewhere on the board
+9VA: D1.2, J1.1, R1.2
-9VA: D1.3, J1.2
GND: C1.2, C3.2, C4.2, C6.2, C7.2, C36.2, C38.2, C40.2, D1.4 (-), D3.2 (A), D9.2 (A), H1.1 (1_1), H2.1 (1_1), H3.1 (1_1), H4.1 (1_1), R52.1, SW1.3 (C), SW2.1, SW3.1, SW4.1, TP2.1 (1_1), TP4.1 (1_1), U1.3, U1.7 (GND), U34.4 (GND), U34.6 (ISET); also elsewhere on the board
HADV: U1.8; also elsewhere on the board
MADV: U1.10; also elsewhere on the board
unnamed: C37.1, R49.2
unnamed: C40.1, R53.2
unnamed: D2.2 (A), D3.1 (K), R1.1, U1.1
unnamed: D4.2 (A), R2.2, R15.2, SW2.2
unnamed: C3.1, D4.1 (K), R2.1, U1.9
unnamed: D6.2 (A), R5.2, R16.2, SW3.2
unnamed: C6.1, D6.1 (K), R5.1, U1.11
unnamed: D7.2 (A), R6.2, R17.2, SW4.2
unnamed: C7.1, D7.1 (K), R6.1, U1.13
unnamed: R50.1, R51.2
unnamed: R49.1, U34.1 (BS)
unnamed: R19.1, U34.7 (EN)
unnamed: R51.1, R52.2, U34.5 (FB)
unnamed: C36.1, U34.8 (SS)
REFCLK: U1.2; also elsewhere on the board
SRST: U1.12; also elsewhere on the board
TW: SW1.2 (B); also elsewhere on the board
VIN: C1.1, D1.1 (+), R19.2, TP1.1 (1_1), U34.2 (IN)
VOUT: C37.2, D9.1 (K), L2.1, R53.1, U34.3 (SW)

Notes on the sheet:
seconds reset
hours advance
60Hz
minutes advance
12/24 select

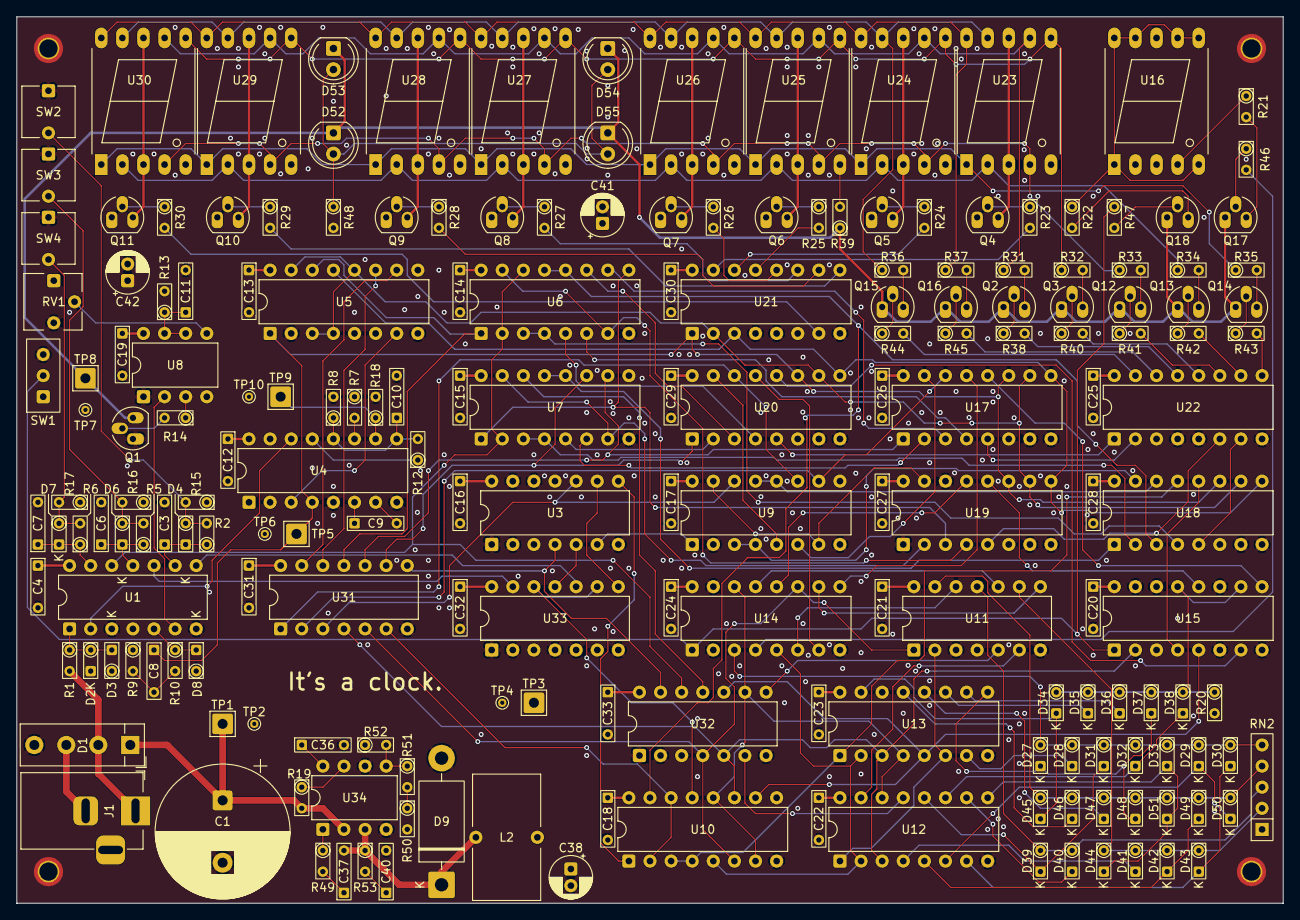
[picture p10: board bvclock.kicad_pcb from above]

Board: 4 copper layers, 152.4 x 106.7 mm, 197 parts (0 on the bottom side), 182 nets.
