koushiniku/bvclock/(commit log)

2026-09-27 increased resistor for colon LEDs
    [display.kicad_sch]
2026-09-27 adjusted some input voltages
    [power.kicad_sch]
2026-10-02 started a second version
    [counters.kicad_sch, display.kicad_sch, power.kicad_sch]
2026-10-03 switched to diode logic; added LED dimmer
    [counters.kicad_sch, display.kicad_sch, power.kicad_sch]
2026-10-04 diode matrix rom
    [bvclock.kicad_sch, counters.kicad_sch, display.kicad_sch, hours.kicad_sch]
2026-10-04 24-12 converter cleanup
    [24-12_hour_map.ods, counters.kicad_sch, display.kicad_sch, hours.kicad_sch, power.kicad_sch]
2026-10-05 added some PCB footprints
    [counters.kicad_sch, display.kicad_sch, hours.kicad_sch, power.kicad_sch]
2026-10-12 switched to PWM for LEDs
2026-10-18 preliminary PCB design
2026-10-25 switch fix, testpoint for DEMOUT, rearrange resistors
2026-10-28 changed buck converter
